GrishinaTanya/-LC-/README.md

Создание измерителя LC (индуктивности и емкости) на Atmega328P

Цель:
Разработать прибор - измеритель LC на плате Arduino-Pro-Mini с применением LCD индикатора. Научиться писать программу на СИ и применять программатор для загрузки скетча в микроконтроллер.
