GrishinaTanya/-LC-/(commit log)

2024-03-31 Create Аналоги
2024-04-22 Rename prezentatsia.pptx to КТ 1/prezentatsia.pptx
2024-04-22 Rename календарный план.xlsx to КТ 1/календарный план.xlsx
    [календарный план.xlsx]
2024-05-29 Rename календарный план.xlsx to 3КТ/календарный план.xlsx
    [календарный план.xlsx]
2024-05-30 Create демонстрация работы прибора
2024-05-30 Create видеопрезентация
